cyanling2/Riding-Assistance/STOP_sign_detection/testimgs/street2.jpg

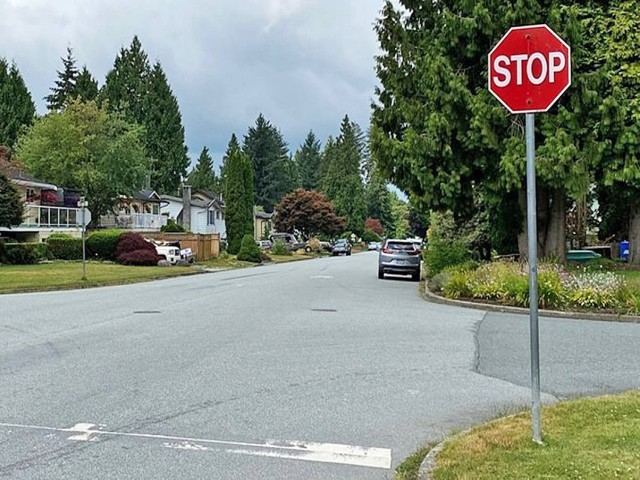
STOP_sign_detection/testimgs/street2.jpg
