cyanling2/Riding-Assistance/STOP_sign_detection/testimgs/street3.jpg

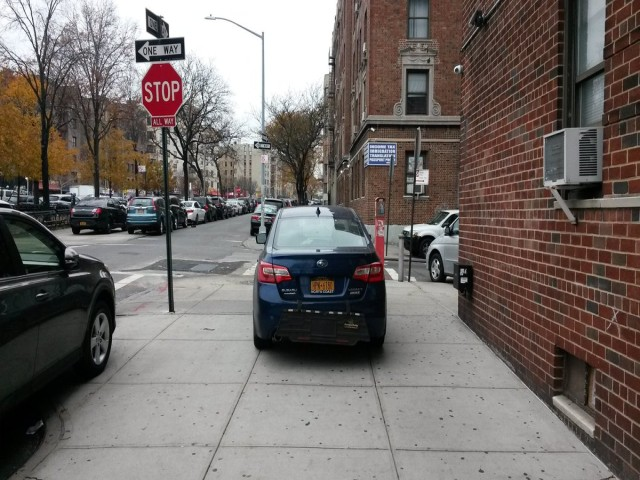
STOP_sign_detection/testimgs/street3.jpg
