cyanling2/Riding-Assistance/hardware design.png

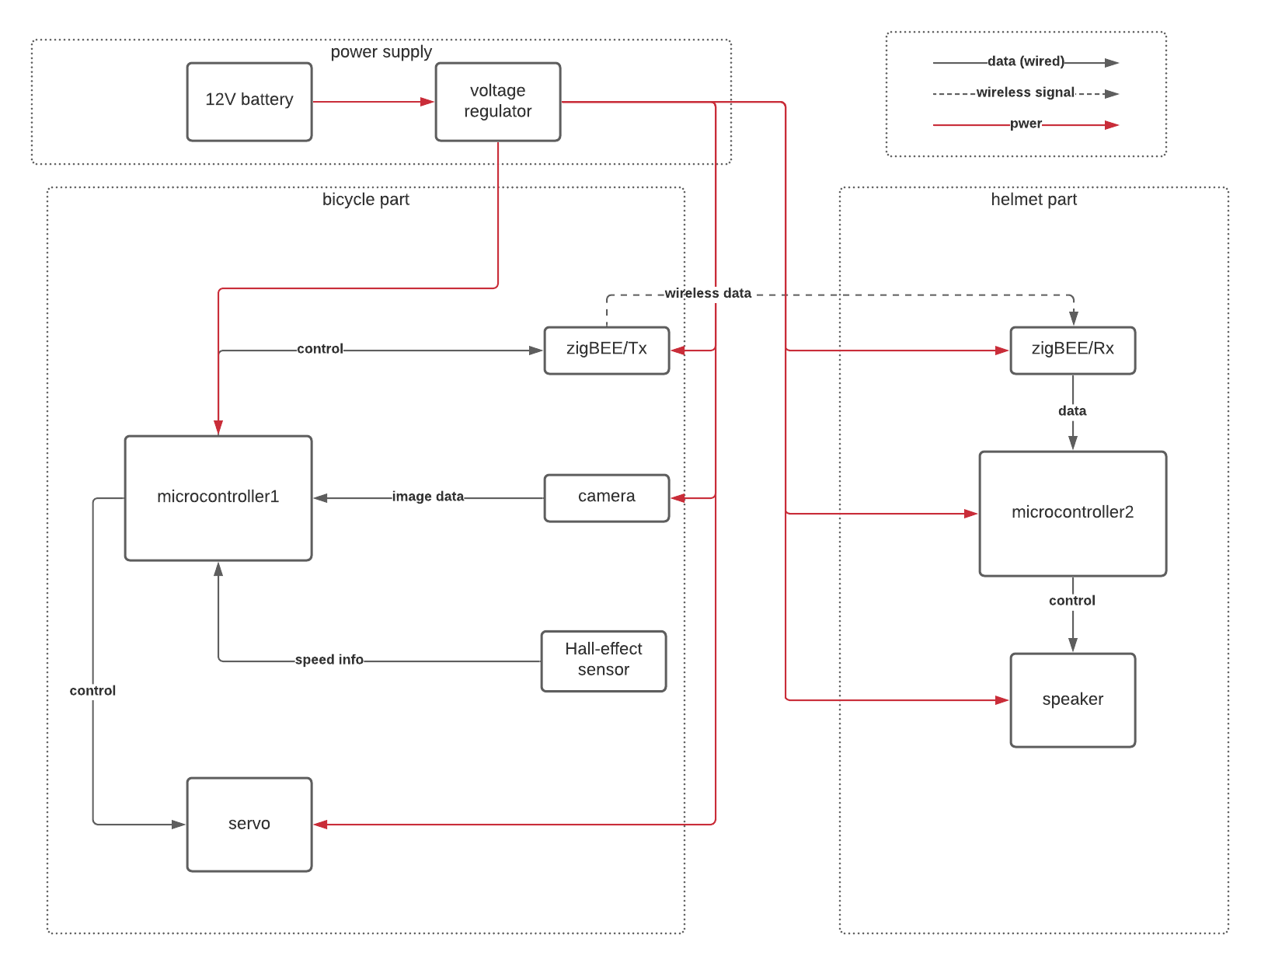
hardware design.png
