cyanling2/Riding-Assistance/software design.png

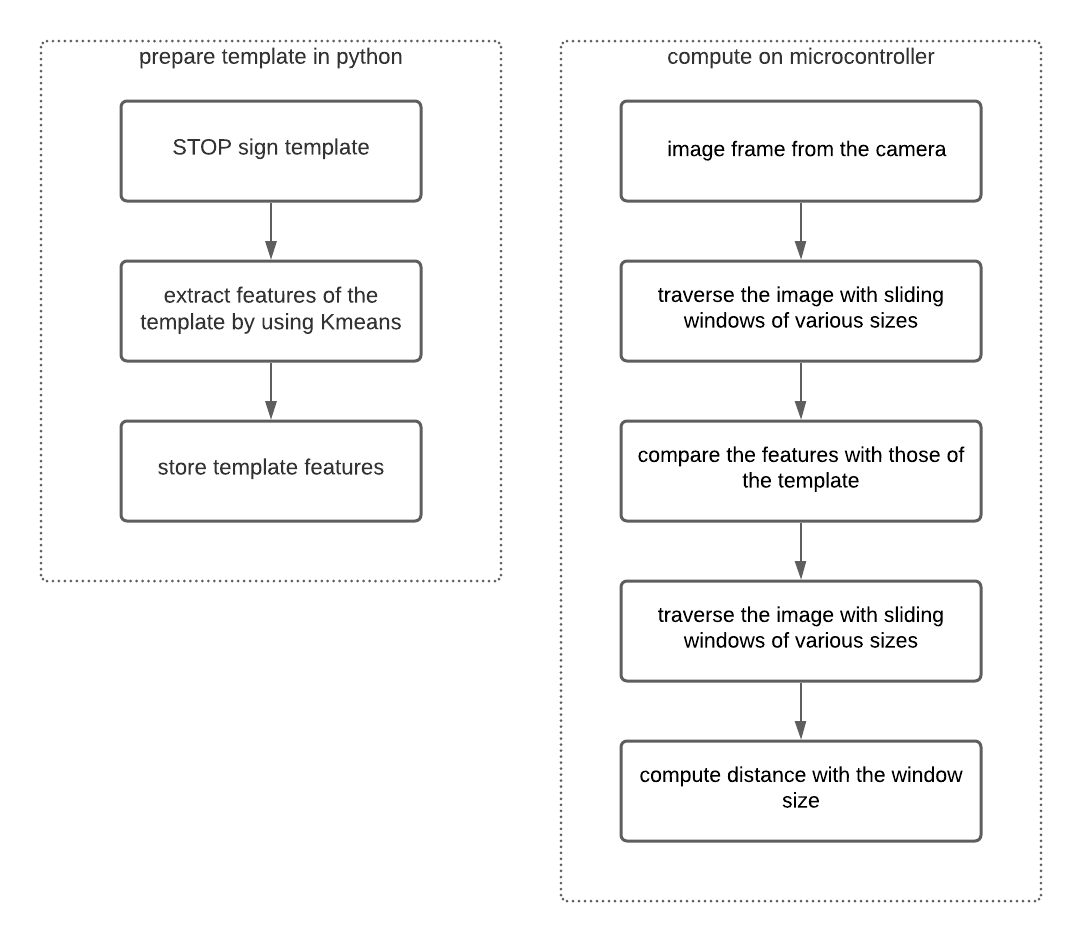
software design.png
