cyanling2/Riding-Assistance/STOP_sign_detection/STOP-removebg-preview.png

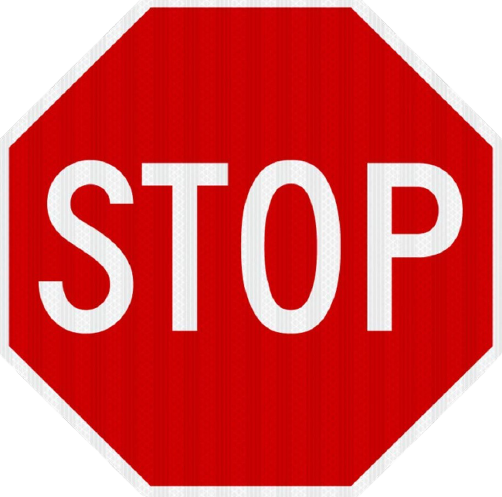
STOP_sign_detection/STOP-removebg-preview.png
