cyanling2/Riding-Assistance/visual_aid.jpg

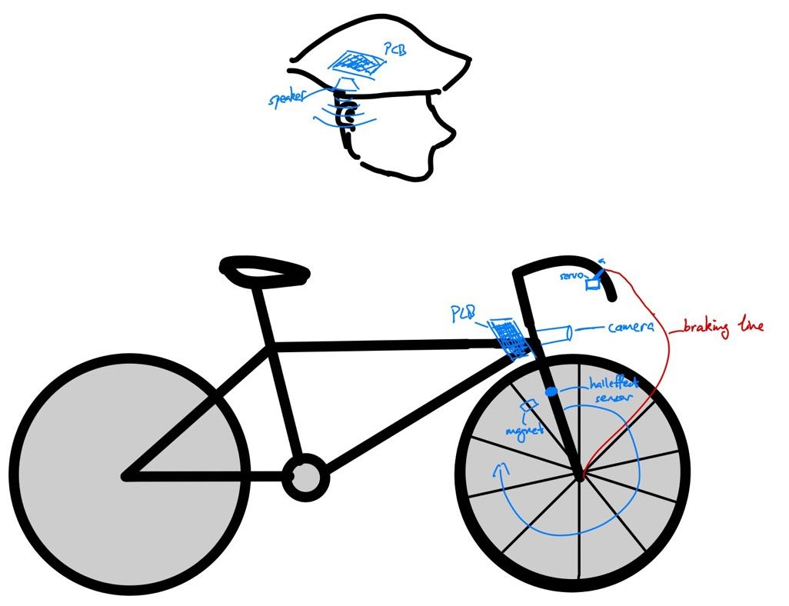
visual_aid.jpg
