cyanling2/Riding-Assistance/STOP_sign_detection/testimgs/f1b7c3c3950a8654d3393265fb859f4.jpg

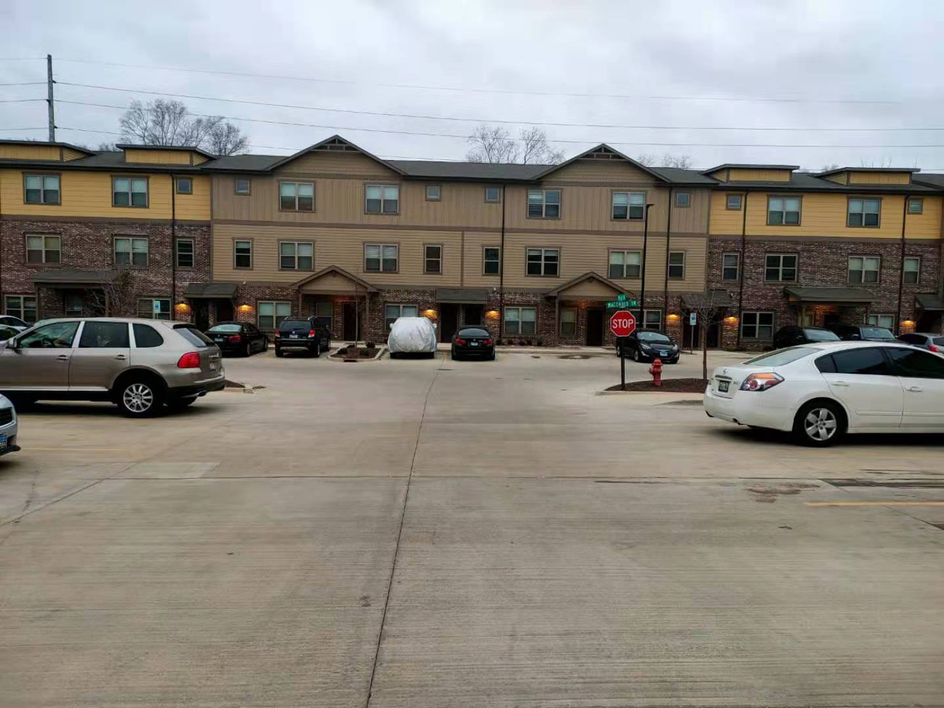
STOP_sign_detection/testimgs/f1b7c3c3950a8654d3393265fb859f4.jpg
