cyanling2/Riding-Assistance/STOP_sign_detection/testimgs/street1.jpg

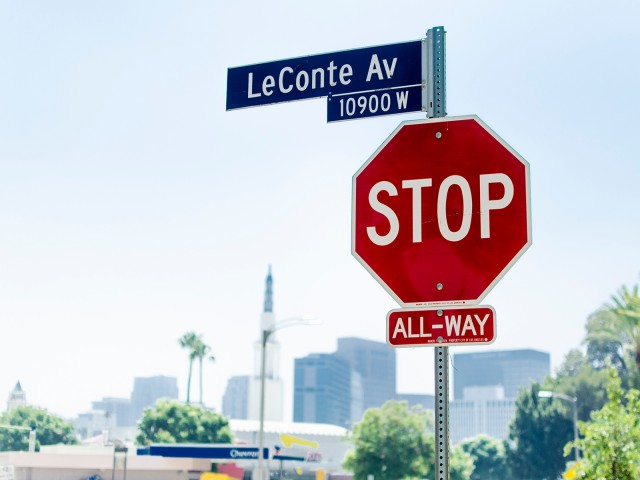
STOP_sign_detection/testimgs/street1.jpg
